BOJIT/Super-Savvy-CNC/README.md

# Super-Savvy-CNC
Open Source CNC Control over Wifi with Telemetry

Currently, this project has been shelved - it may be revisited in the future. See the article for more details:

Project Write-Up Here: [https://bojit.github.io/projects/Stepper_Driver/]
