BOJIT/Super-Savvy-CNC/Base Github Projects/Trampas Stern Project/Nano_zero_stepper_Schematics.pdf

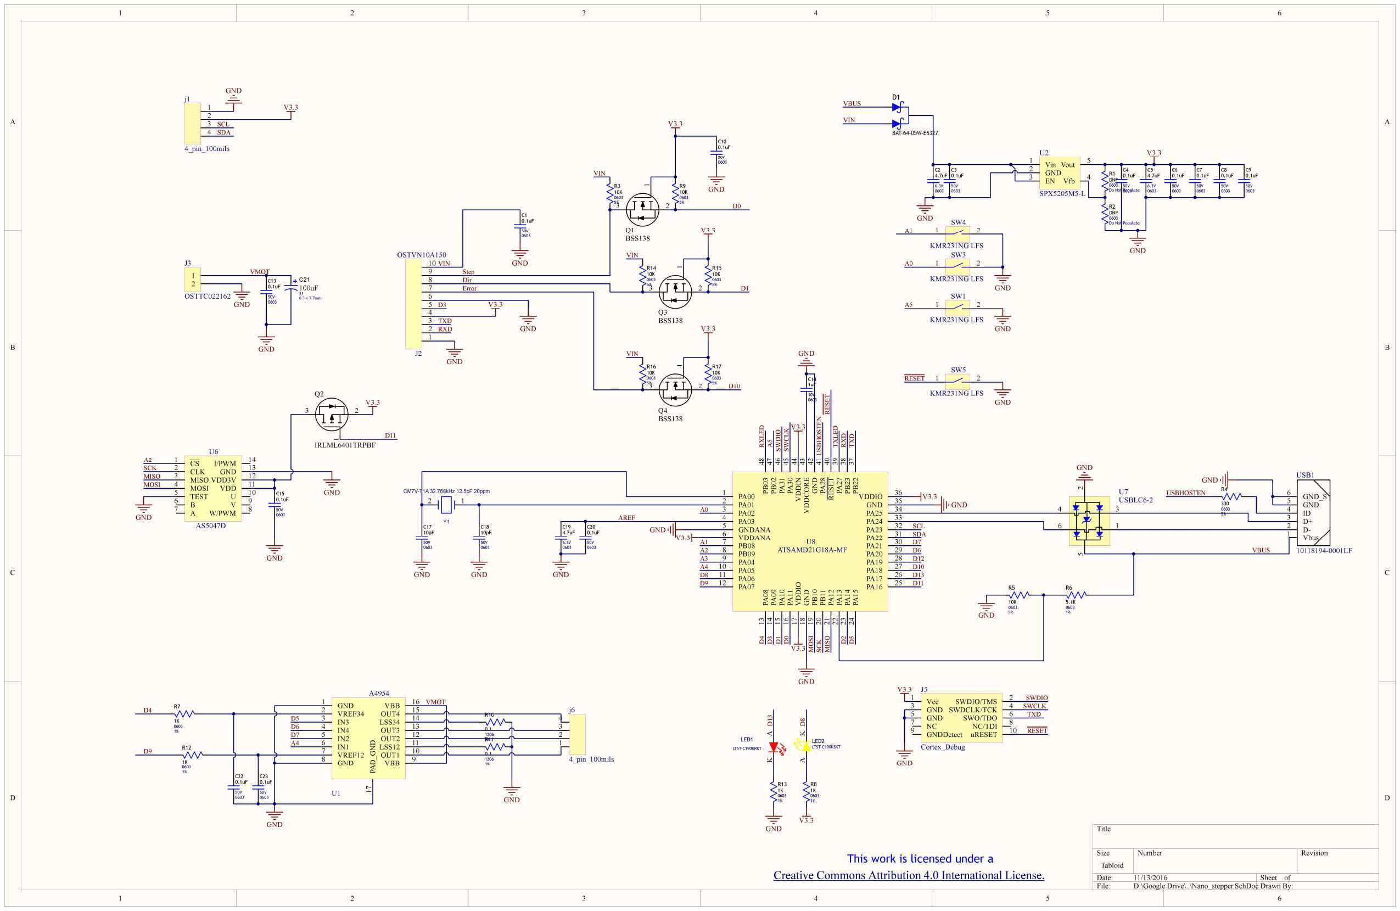
[picture p1: page 1]

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
Title

Size | Number | Revision
Tabloid
Date: | 11/13/2016 | Sheet of
File: | D:\Google Drive\..\Nano_stepper.SchDoc Drawn By:

CS 1
CLK 2
MISO 3
MOSI 4
TEST 5
B

6
A
7 | W/PWM | 8
| V | 9

U

10 VDD | 11 VDD3V | 12 GND | 13 I/PWM | 14

U6

AS5047D

PA00 1
PA01 2
PA02 3
PA03 4
GNDANA 5
VDDANA 6
PB08 7
PB09 8
PA04 9
PA05 10
PA06 11
PA07 12 | PA⁰⁸ 13 PA⁰⁹ 14 PA¹⁰ 15 PA¹¹ 16 VDDIO 17 GND 18 PB¹⁰ 19 PB¹¹ 20 PA¹² 21 PA¹³ 22 PA¹⁴ 23 PA¹⁵ 24
PA16 | 25 PA17 | 26 PA18 | 27 PA19 | 28 PA20 | 29 PA21 | 30 PA22 | 31 PA23 | 32 PA24 | 33 PA25 | 34 GND | 35 VDDIO PB²² | 36 ³⁷ PB²³ ³⁸ PA²⁷ ³⁹ RESET ⁴⁰ PA²⁸ ⁴¹ GND ⁴² VDDCORE ⁴³ VDDIN ⁴⁴ PA³⁰ ⁴⁵ PA³¹ ⁴⁶ PB⁰² ⁴⁷ PB⁰³ ⁴⁸

U8
ATSAMD21G18A-MF

2 1

Y1

CM7V-T1A 32.768kHz 12.5pF 20ppm

0603

50V

C18
10pF

0603

50V

C17
10pF
GND | GND | MOSI SCK MISO

VBUS

GND

GND

GND

GND

V3.3

V3.3

V3.3

V3.3

0603

10V

C14
1uF

GND

Vcc 1

| SWDIO/TMS | 2
GND 3
| SWDCLK/TCK | 4
GND 5
| SWO/TDO | 6
NC 7 | NC/TDI | 8
GNDDetect 9
| nRESET | 10

J5

# Cortex_Debug RESET

RESET SWDIO

SWDIO SWCLK

SWCLK

V3.3

GND A K LED2

LTST-C190KSKT

0603
1%

R13
1K
0603
1%

R8
1K

1 2

SW5

KMR231NG LFS
GND

RESET

A0
AREF

A1
A2
A3
A4
D8
D9 | D⁴ D³ D¹ D⁰ | D² D⁵

D11

D13

D10

D12

D6

D7

SDA

SCL RXD USBHOSTEN RXLED A⁵ | TXLED

A K
LED1

LTST-C190KRKT

# GNDD¹³

0603
5%

R4

330

USBHOSTEN

0603

50V

C20
0.1uF

0603

6.3V

C19
4.7uF

GND

# V3.3 D⁸

2 5

6

4

1

3

U7
USBLC6-2

GND

Vbus

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
GND_S

6

USB1

10118194-0001LF

TXD TXD

0603
5%

R5

10K
0603
1%

R6

5.1K
GND

A2

MOSI

MISO

SCK

GND

GND

Vin 1
GND 2
EN 3 | Vfb | 4
| Vout | 5

U2

SPX5205M5-L

GND

0603

50V

C4
0.1uF

0603

50V

C3
0.1uF

0603
Do Not Populate

R2
DNP

0603
Do Not Populate

R1
DNP

0603

50V

C6
0.1uF

0603

50V

C7
0.1uF

0603

50V

C8
0.1uF

0603

50V

C9
0.1uF

D1

BAT-64-05W-E6327

0603

6.3V

C5
4.7uF

VIN

VBUS

0603

6.3V

C2
4.7uF

V3.3

GND

0603

50V

C15
0.1uF

GND

GND

VMOT

GND

0603

50V

C13
0.1uF

VIN

D0

RXD | GND

GND

TXD

GND

D1

Step
Dir
Error

D3

### 6.3 x 7.7mm

100uF
35

C21

GND 1
VREF34 2
IN3 3
IN4 4
IN2 5
IN1 6
VREF12 7
GND 8 | VBB | 9
OUT1 | 10 LSS12 | 11 OUT2 | 12 OUT3 | 13 LSS34 | 14 OUT4 | 15 VBB | 16 PAD_GND
U1 | 17

A4954

D4

0603
1%

R7

1K

0603

50V

C22
0.1uF

0603

50V

C23
0.1uF

0603
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
1206
1%

R10

0.1

1206
1%

R11

0.1

VMOT

GND

1

2

3

4

j6

4_pin_100mils

D10

V3.3

D11

1 2

SW1

KMR231NG LFS
GND

1
2
3
4

j1

4_pin_100mils

A5

1 2

SW3

KMR231NG LFS
GND

A0

A4

1

3 2

Q2

IRLML6401TRPBF

1
2

J3

OSTTC022162

1 2

SW4

KMR231NG LFS

A1 ¹

3 2

Q1
BSS138

0603
5%

R3
10K

V3.3

0603
5%

R9
10K

VIN

0603

50V

C1
0.1uF | 1

3 2

Q3
BSS138

0603
5%

R14
10K

V3.3

0603
5%

R15
10K

# VIN 1

3 2

Q4
BSS138

0603
5%

R16
10K

V3.3

0603
5%

R17
10K

VIN

V3.3

0603

50V

C10
0.1uF

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
OSTVN10A150

SDA

SCL

V3.3

GND

## This work is licensed under a

Creative Commons Attribution 4.0 International License.
