BOJIT/Super-Savvy-CNC/Base Github Projects/Mechaduino Project/Mechaduino-Firmware-master/Mechaduino-Firmware-master/images/header.PNG

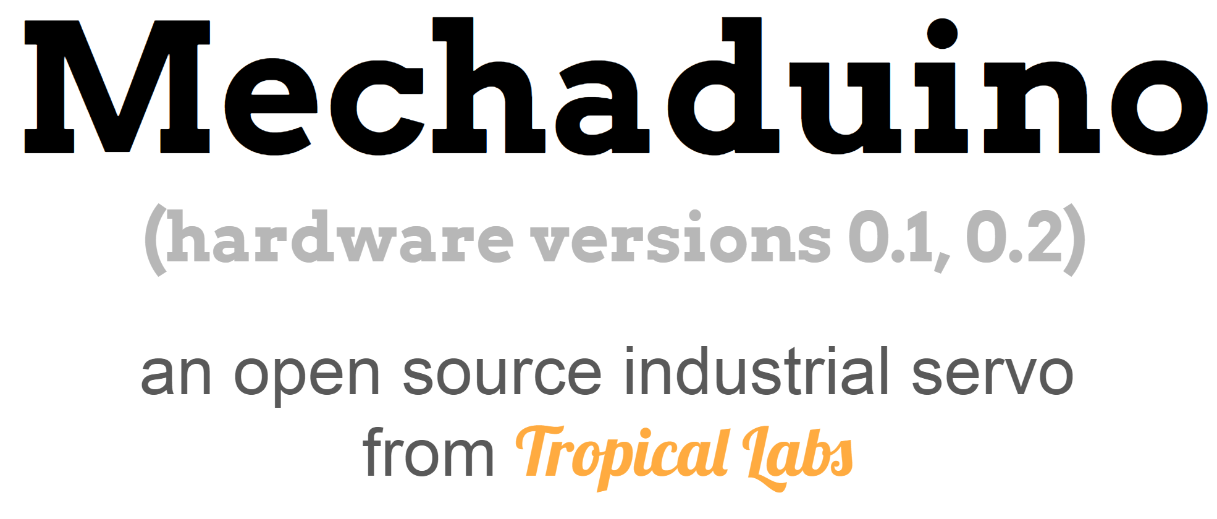
Base Github Projects/Mechaduino Project/Mechaduino-Firmware-master/Mechaduino-Firmware-master/images/header.PNG
