BOJIT/Super-Savvy-CNC/Base Github Projects/Mechaduino Project/Mechaduino-Hardware-Mechaduino-0.2/Mechaduino-Hardware-Mechaduino-0.2/Mechaduino_02_Schematic.png

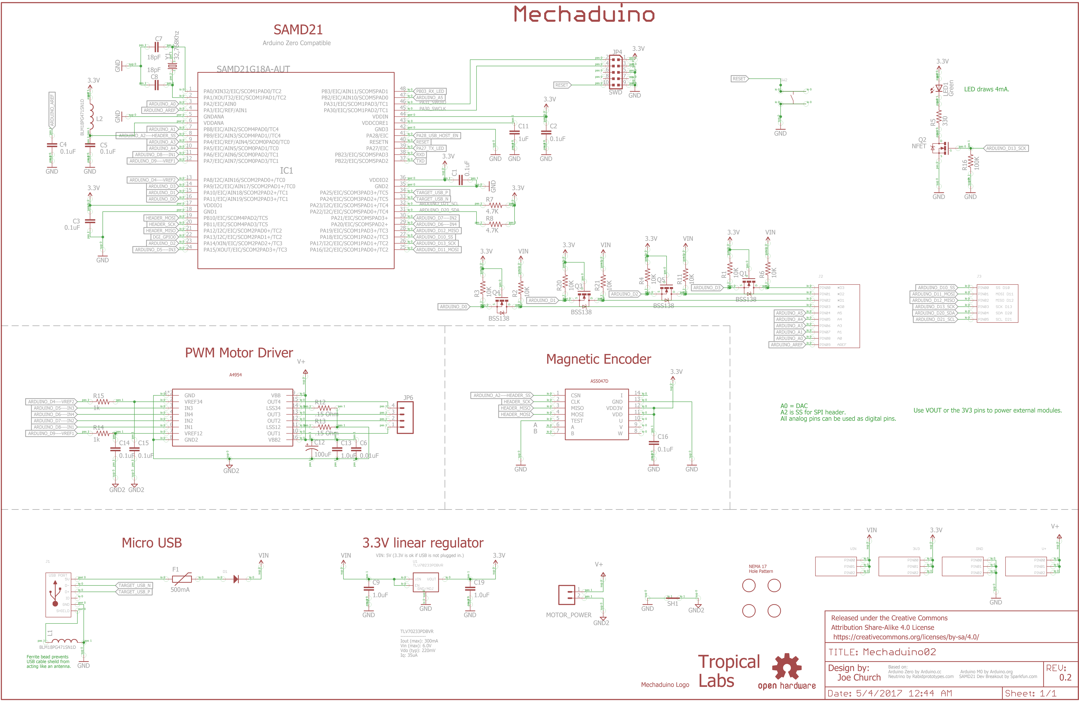
Base Github Projects/Mechaduino Project/Mechaduino-Hardware-Mechaduino-0.2/Mechaduino-Hardware-Mechaduino-0.2/Mechaduino_02_Schematic.png
