BOJIT/Super-Savvy-CNC/(list of files, drawings)

Other design files:
Base Github Projects/Trampas Stern Project/nano_stepper-master/hardware/Nano_stepper.SchDoc
Base Github Projects/Trampas Stern Project/nano_stepper-master/hardware/NZS_A4954_R2.0.PrjPcb
Base Github Projects/Trampas Stern Project/nano_stepper-master/hardware/NZS_A4954_R2_0.PcbDoc
