BOJIT/Super-Savvy-CNC/Base Github Projects/Mechaduino Project/Mechaduino-Hardware-Mechaduino-0.2/Mechaduino-Hardware-Mechaduino-0.2/Mechaduino02.brd

## EAGLE design Base Github Projects/Mechaduino Project/Mechaduino-Hardware-Mechaduino-0.2/Mechaduino-Hardware-Mechaduino-0.2/Mechaduino02.brd (2018-01-04)

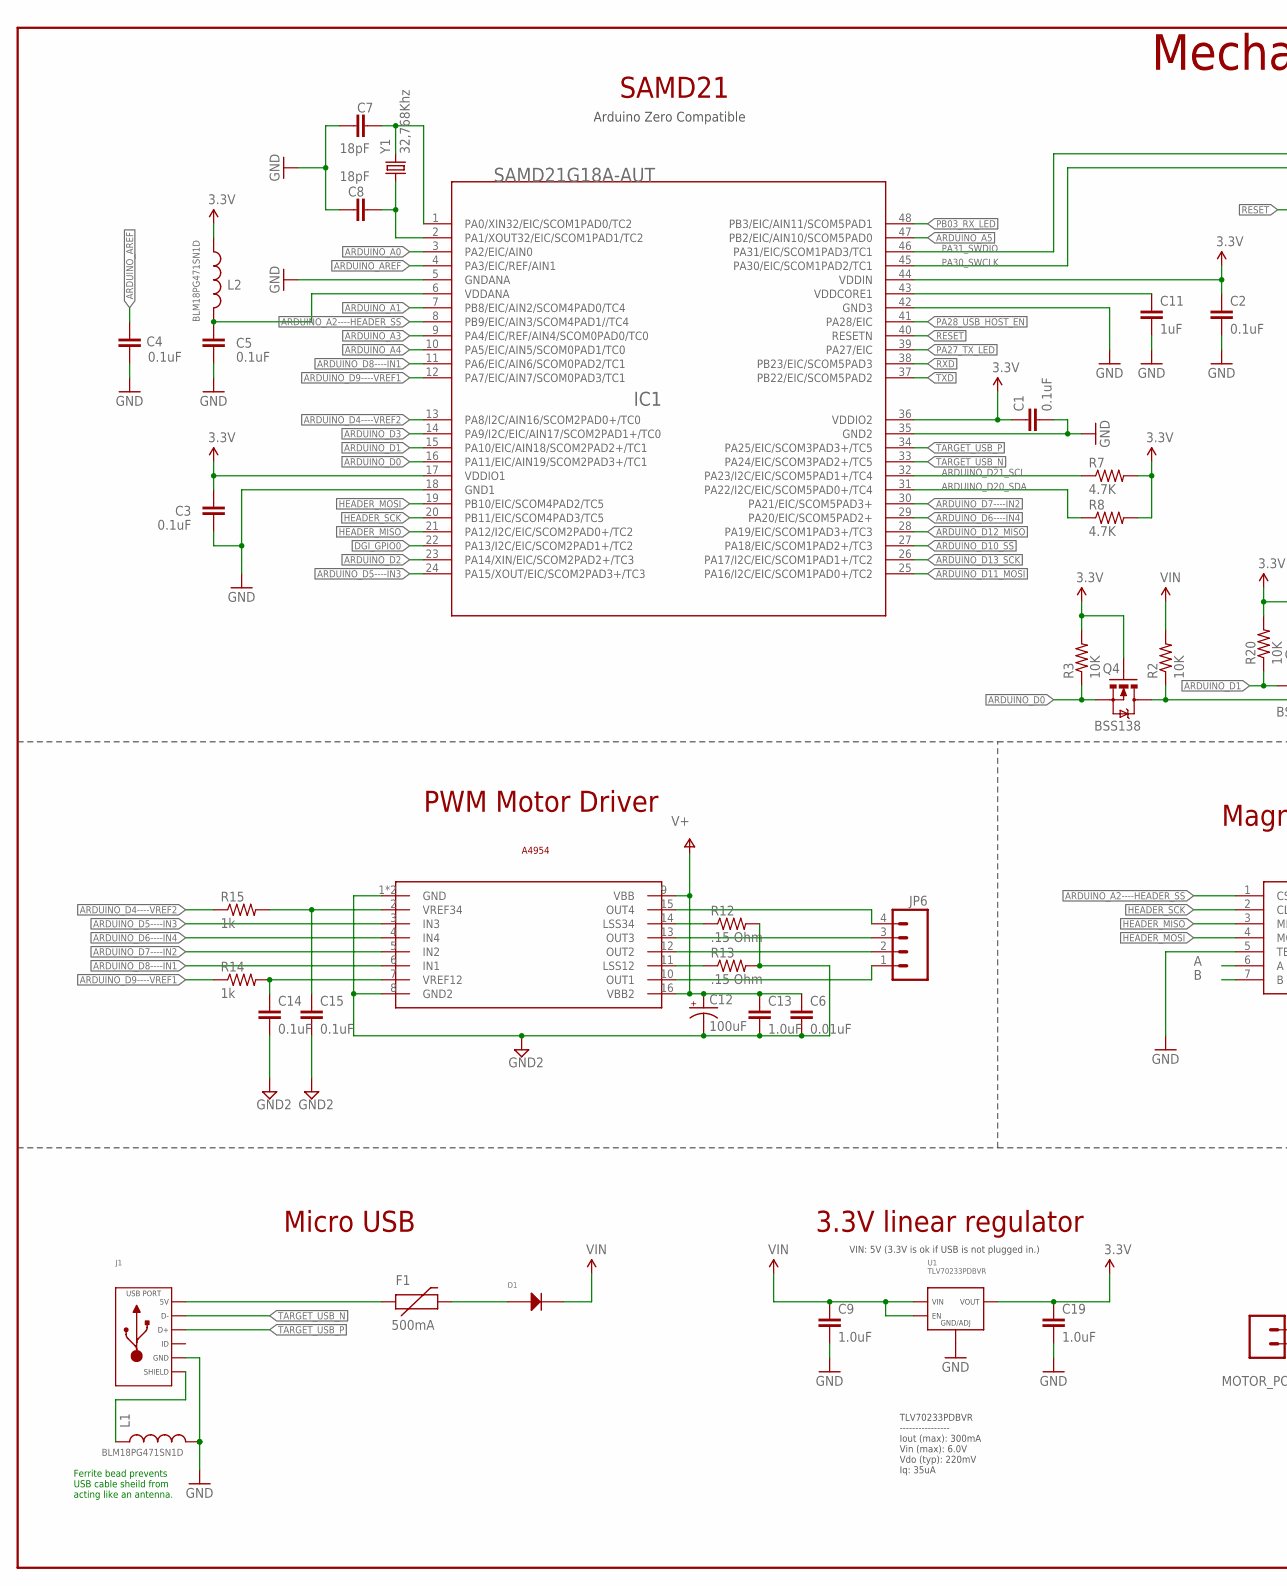
[picture p13: schematic Mechaduino02.sch, part in row 1, column 1]

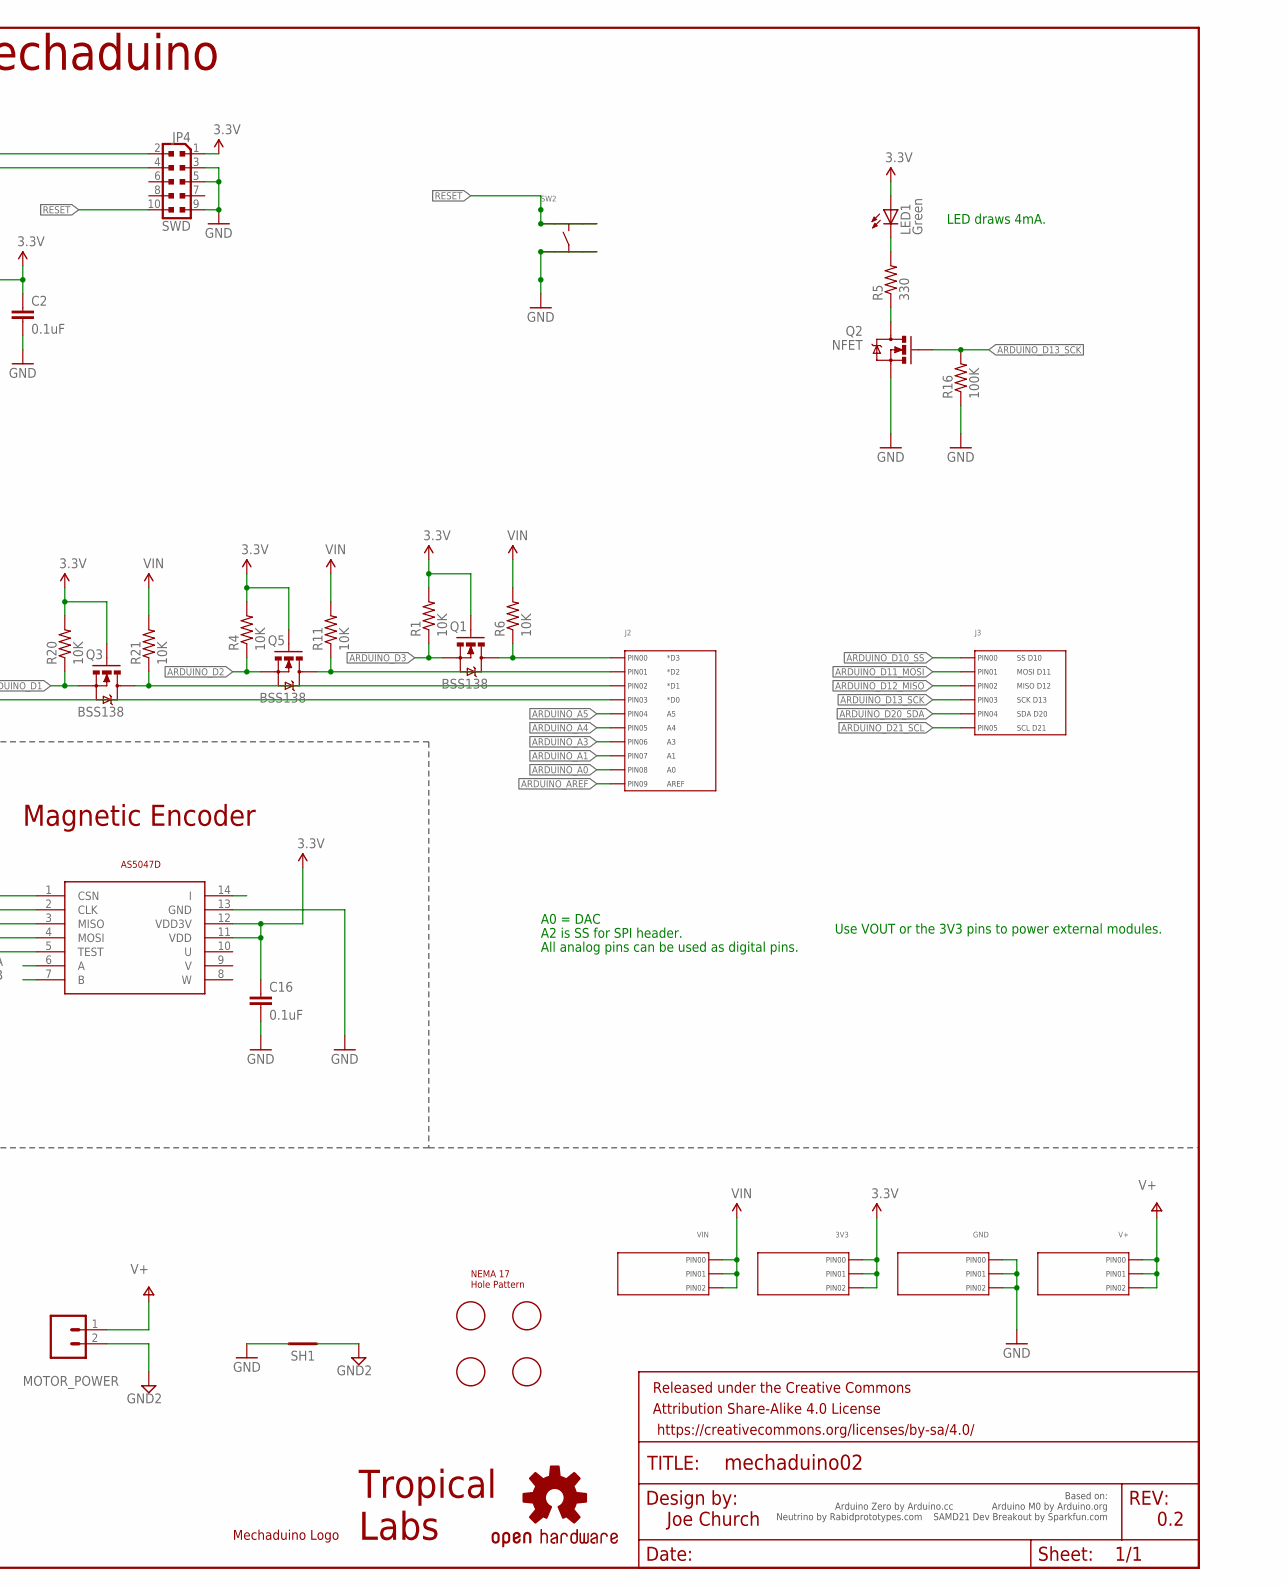
[picture p14: schematic Mechaduino02.sch, part in row 1, column 2]

Parts:
3V3: HEADER_01X03_PTH_2.54MM; PTH_2.54MM_01X03
C1, C2, C3, C4, C5, C14, C15, C16: 0.1uF; 0402-CAP
C6: 0.01uF; 0603-CAP
C7, C8: 18pF; 0603-CAP
C9, C19: 1.0uF; 0402-CAP
C11: 1uF; 0402-CAP
C12: 100uF; PANASONIC_D
C13: 1.0uF; 0603-CAP
D1: DIODE_SOD-123; SOD-123
F1: 500mA; PTC-1206
FRAME1: FRAME-LEDGER; CREATIVE_COMMONS
GND: HEADER_01X03_PTH_2.54MM; PTH_2.54MM_01X03
IC1: SAMD21G18A-AUT; INTEGRATEDCIRCUITS_TQFP48-7X7
J1: USB_MICRO_RIGHT; MICROUSB-RIGHT
J2: HEADER_01X10_PTH_2.54MM; PTH_2.54MM_01X10
J3: HEADER_01X06_PTH_2.54MM; PTH_2.54MM_01X06
JP4: SWD; CONNETTORI_PINHEAD-2X5-P127
JP6: M04PTH; 1X04
L1, L2: BLM18PG471SN1D; 0603-TDK
LED1: Green; CHIPLED_0805
LOGO4: OSHW-LOGOMOD; OSHW_LOGO_COPPER_MOD
MOTOR_POWER: M025MM; SCREWTERMINAL-5MM-2
Q1, Q3, Q4, Q5: BSS138; SOT23-3
Q2: NFET; SOT323
R1, R2, R3, R4, R6, R11, R20, R21: 10K; R0402-VISHAY
R5: 330; R0402-VISHAY
R7, R8: 4.7K; R0402-VISHAY
R12, R13: .15 Ohm; R1206
R14, R15: 1k; R0402-VISHAY
R16: 100K; R0402-VISHAY
SH1: SHORT-HA5; SHORT_ALL-50
SW2: TACT_4.2MM; TACT4.2MM
U1: TLV70233PDBVR; SOT-23-5
U$1: AVAGO_DRIVERTHERM; TSSOP16_THERM
U$2: NEMA17_HOLE_PATTERNNEW; NEMA17_HOLE_PATTERN_2
U$3: TROPICAL_LABS_LOGO_1LOGO3; LOGO3
U$4: AS5047D; TSSOP14
U$5: MECHADUINO_LOGO
V+: HEADER_01X03_PTH_2.54MM; PTH_2.54MM_01X03
VIN: HEADER_01X03_PTH_2.54MM; PTH_2.54MM_01X03
Y1: 32,768Khz; CRYSTAL-SMD-2.0X1.2

Connections:
3.3V: 3V3.P$1 (PIN0), 3V3.P$2 (PIN1), 3V3.P$3 (PIN2), C1.1, C2.1, C3.2, C16.1, C19.1, IC1.17 (VDDIO1), IC1.36 (VDDIO2), IC1.44 (VDDIN), JP4.1, L2.1, LED1.A, Q1.1 (G), Q3.1 (G), Q4.1 (G), Q5.1 (G), R1.2, R3.2, R4.2, R7.2, R8.2, R20.2, U1.P$5 (VOUT), U$4.11 (VDD), U$4.12 (VDD3V)
A: U$4.6 (A)
ARDUINO_A0: IC1.3 (PA2/EIC/AIN0), J2.P$9 (PIN8)
ARDUINO_A1: IC1.7 (PB8/EIC/AIN2/SCOM4PAD0/TC4), J2.P$8 (PIN7)
ARDUINO_A2----HEADER_SS: IC1.8 (PB9/EIC/AIN3/SCOM4PAD1//TC4), U$4.1 (CSN)
ARDUINO_A3: IC1.9 (PA4/EIC/REF/AIN4/SCOM0PAD0/TC0), J2.P$7 (PIN6)
ARDUINO_A4: IC1.10 (PA5/EIC/AIN5/SCOM0PAD1/TC0), J2.P$6 (PIN5)
ARDUINO_A5: IC1.47 (PB2/EIC/AIN10/SCOM5PAD0), J2.P$5 (PIN4)
ARDUINO_AREF: C4.1, IC1.4 (PA3/EIC/REF/AIN1), J2.P$10 (PIN9)
ARDUINO_D0: IC1.16 (PA11/EIC/AIN19/SCOM2PAD3+/TC1), Q4.2 (S), R3.1
ARDUINO_D1: IC1.15 (PA10/EIC/AIN18/SCOM2PAD2+/TC1), Q3.2 (S), R20.1
ARDUINO_D2: IC1.23 (PA14/XIN/EIC/SCOM2PAD2+/TC3), Q5.2 (S), R4.1
ARDUINO_D3: IC1.14 (PA9/I2C/EIC/AIN17/SCOM2PAD1+/TC0), Q1.2 (S), R1.1
ARDUINO_D4----VREF2: IC1.13 (PA8/I2C/AIN16/SCOM2PAD0+/TC0), R15.1
ARDUINO_D5----IN3: IC1.24 (PA15/XOUT/EIC/SCOM2PAD3+/TC3), U$1.3 (IN3)
ARDUINO_D6----IN4: IC1.29 (PA20/EIC/SCOM5PAD2+), U$1.4 (IN4)
ARDUINO_D7----IN2: IC1.30 (PA21/EIC/SCOM5PAD3+), U$1.5 (IN2)
ARDUINO_D8----IN1: IC1.11 (PA6/EIC/AIN6/SCOM0PAD2/TC1), U$1.6 (IN1)
ARDUINO_D9----VREF1: IC1.12 (PA7/EIC/AIN7/SCOM0PAD3/TC1), R14.1
ARDUINO_D10_SS: IC1.27 (PA18/EIC/SCOM1PAD2+/TC3), J3.P$1 (PIN0)
ARDUINO_D11_MOSI: IC1.25 (PA16/I2C/EIC/SCOM1PAD0+/TC2), J3.P$2 (PIN1)
ARDUINO_D12_MISO: IC1.28 (PA19/EIC/SCOM1PAD3+/TC3), J3.P$3 (PIN2)
ARDUINO_D13_SCK: IC1.26 (PA17/I2C/EIC/SCOM1PAD1+/TC2), J3.P$4 (PIN3), Q2.1 (G), R16.2
ARDUINO_D20_SDA: IC1.31 (PA22/I2C/EIC/SCOM5PAD0+/TC4), J3.P$5 (PIN4), R8.1
ARDUINO_D21_SCL: IC1.32 (PA23/I2C/EIC/SCOM5PAD1+/TC4), J3.P$6 (PIN5), R7.1
B: U$4.7 (B)
DGI_GPIO0: IC1.22 (PA13/I2C/EIC/SCOM2PAD1+/TC2)
GND: C1.2, C2.2, C3.1, C4.2, C5.2, C7.1, C8.1, C9.2, C11.2, C16.2, C19.2, GND.P$1 (PIN0), GND.P$2 (PIN1), GND.P$3 (PIN2), IC1.5 (GNDANA), IC1.18 (GND1), IC1.35 (GND2), IC1.42 (GND3), J1.5 (GND), JP4.3, JP4.5, JP4.9, L1.2, Q2.2 (S), R16.1, SH1.2, SW2.P$3, SW2.P$4, U1.P$2 (GND/ADJ), U$4.5 (TEST), U$4.13 (GND)
GND2: C6.2, C12.-, C13.2, C14.2, C15.2, MOTOR_POWER.2, R12.2, R13.2, SH1.1, U$1.1 (GND), U$1.8 (GND2), U$1.P$1 (GND)
HEADER_MISO: IC1.21 (PA12/I2C/EIC/SCOM2PAD0+/TC2), U$4.3 (MISO)
HEADER_MOSI: IC1.19 (PB10/EIC/SCOM4PAD2/TC5), U$4.4 (MOSI)
HEADER_SCK: IC1.20 (PB11/EIC/SCOM4PAD3/TC5), U$4.2 (CLK)
HV1: J2.P$3 (PIN2), Q3.3 (D), R21.1
HV2: J2.P$4 (PIN3), Q4.3 (D), R2.1
HV3: J2.P$2 (PIN1), Q5.3 (D), R11.1
HV4: J2.P$1 (PIN0), Q1.3 (D), R6.1
I: U$4.14 (I)
unnamed: LED1.C, R5.2
unnamed: R12.1, U$1.14 (LSS34)
unnamed: Q2.3 (D), R5.1
unnamed: R13.1, U$1.11 (LSS12)
unnamed: C15.1, R15.2, U$1.2 (VREF34)
unnamed: JP6.4, U$1.15 (OUT4)
unnamed: JP6.1, U$1.10 (OUT1)
unnamed: JP6.2, U$1.12 (OUT2)
unnamed: JP6.3, U$1.13 (OUT3)
unnamed: C14.1, R14.2, U$1.7 (VREF12)
unnamed: D1.ANODE, F1.2
unnamed: F1.1, J1.1 (5V)
PA00_XIN32: C7.2, IC1.1 (PA0/XIN32/EIC/SCOM1PAD0/TC2), Y1.2
PA01_XOUT32: C8.2, IC1.2 (PA1/XOUT32/EIC/SCOM1PAD1/TC2), Y1.1
PA27_TX_LED: IC1.39 (PA27/EIC)
PA28_USB_HOST_EN: IC1.41 (PA28/EIC)
PA30_SWCLK: IC1.45 (PA30/EIC/SCOM1PAD2/TC1), JP4.4
PA31_SWDIO: IC1.46 (PA31/EIC/SCOM1PAD3/TC1), JP4.2
PB03_RX_LED: IC1.48 (PB3/EIC/AIN11/SCOM5PAD1)
RESET: IC1.40 (RESETN), JP4.10, SW2.P$1, SW2.P$2
RXD: IC1.38 (PB23/EIC/SCOM5PAD3)
SHIELD: J1.S1 (SLD), J1.S2 (SLD), J1.S3 (SLD), J1.S4 (SLD), J1.S5 (SLD), J1.S6 (SLD), J1.S7 (SLD), J1.S8 (SLD), L1.1
TARGET_USB_N: IC1.33 (PA24/EIC/SCOM3PAD2+/TC5), J1.2 (D-)
TARGET_USB_P: IC1.34 (PA25/EIC/SCOM3PAD3+/TC5), J1.3 (D+)
TXD: IC1.37 (PB22/EIC/SCOM5PAD2)
V+: C6.1, C12.+, C13.1, MOTOR_POWER.1, U$1.9 (VBB), U$1.16 (VBB2), V+.P$1 (PIN0), V+.P$2 (PIN1), V+.P$3 (PIN2)
VDDANA: C5.1, IC1.6 (VDDANA), L2.2
VDDCORE: C11.1, IC1.43 (VDDCORE1)
VIN: C9.1, D1.CATHODE, R2.2, R6.2, R11.2, R21.2, U1.P$1 (VIN), U1.P$3 (EN), VIN.P$1 (PIN0), VIN.P$2 (PIN1), VIN.P$3 (PIN2)

Notes on the sheet:
A0 = DAC
All analog pins can be used as digital pins.
LED draws 4mA.
A2 is SS for SPI header.
Use VOUT or the 3V3 pins to power external modules.
Ferrite bead prevents USB cable sheild from acting like an antenna.
3.3V linear regulator
Magnetic Encoder
SAMD21
PWM Motor Driver
VIN: 5V (3.3V is ok if USB is not plugged in.)
TLV70233PDBVR ---------------- Iout (max): 300mA Vin (max): 6.0V Vdo (typ): 220mV Iq: 35uA
A4954
Micro USB
Joe Church
Based on: Arduino Zero by Arduino.cc Arduino M0 by Arduino.org Neutrino by Rabidprototypes.com SAMD21 Dev Breakout by Sparkfun.com
0.2
Arduino Zero Compatible
Mechaduino

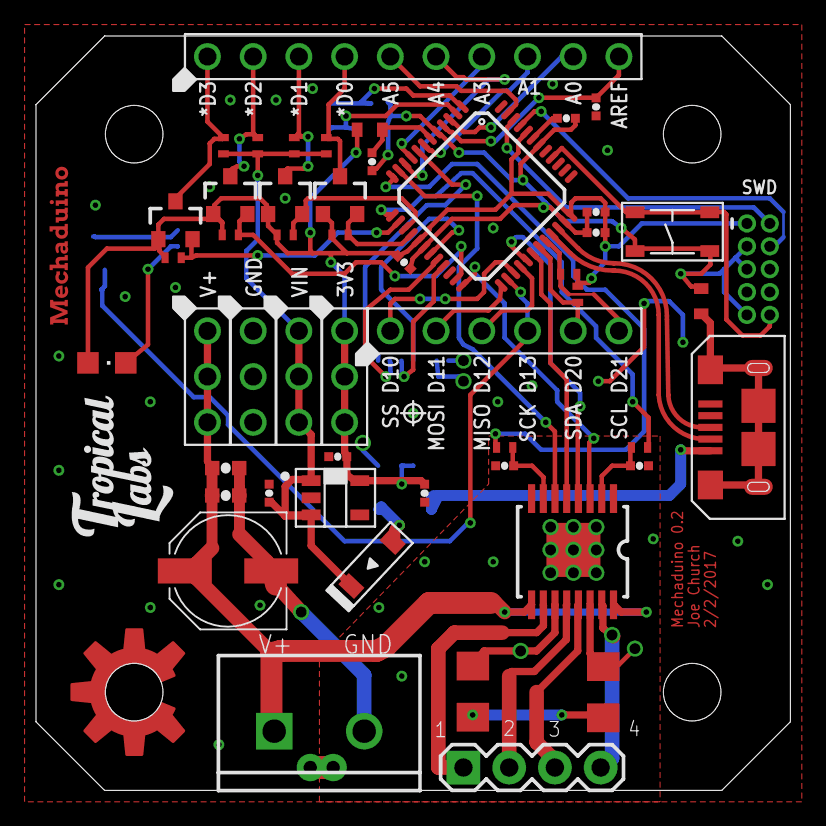
[picture p15: board Mechaduino02.brd from above]

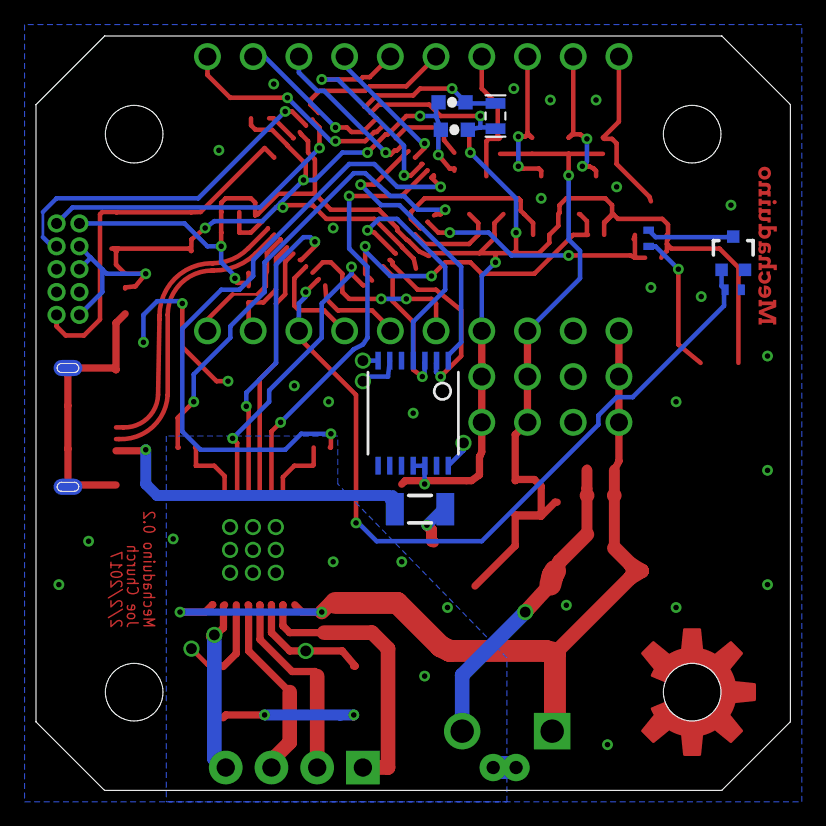
[picture p16: board Mechaduino02.brd from below]

Board: 2 copper layers, 41.9 x 41.9 mm, 64 parts (8 on the bottom side), 57 nets.
